Bri-J-C/CurtainController/(commit log)

2026-01-27 ESP32 Curtain Controller
    Stepper motor curtain controller with web configuration,
    MQTT control, and Home Assistant auto-discovery.
2026-03-08 Rewrite WiFi management for reliable connectivity
    - Replace WiFiManager-based setup with manual boot_wifi_connect() using
    15s timeout and automatic reboot retry when credentials are saved
    - Add 4-state WiFi reconnection state machine (IDLE/LOST/RECONNECTING/BACKOFF)
    with exponential backoff and auto-reboot after 8 failed attempts
    - Config portal only launches for: no saved credentials, or manual button hold
    - Runtime button-hold portal now includes full parameter set (hostname, MQTT, OTA, steps)
    - Fix hostname ordering: WIFI_OFF → WIFI_STA → setHostname → begin
    - Revert mdns_free() which caused device hangs after OTA
    - Clean up debug ets_printf statements, use proper log_msg calls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
    [CurtainController.ino]
2026-03-08 Disable WiFi power saving for more reliable connectivity
    - Add esp_wifi_set_ps(WIFI_PS_NONE) after WiFi connect
    - Reduces ping latency from 40-120ms to ~15ms on local network
2026-03-09 Swap DIR/STEP pins and rewrite README from source
    - Swap DIR to GPIO 6 and STEP to GPIO 10
    - Rewrite README.md from scratch based on actual source code
    - Document pinout, commands, MQTT topics, WiFi behavior, NVS keys
    - Remove references to deleted documentation files
    [CurtainController.ino]
